UeCook/uC_Calc_CoDesign/原理图_PCB图/元器件BOM.pdf

名称 | 器件名称 | 封装参数 | 数量 | 器件供应商 | 嘉立创商城代码
51单片机 | STC89C58RD+40I-PDIP40 | DIP-40 | 1 | 宏晶科技 | C52838
LCD显示屏 | HS1602A | - | 1 | 汉昇实业 | C5329588
单刀单掷轻触开关 | TS665CJ | 6×6×5mm 直插 | 21 | 首韩 | C393938
10uF电容 | - C0805 | | 2
47pF电容 | | | 2
10KΩ电阻 | | | 2
16位排针 | 2.54-1*40P直针 | SIP16-2.54mm | 2 | 博穆精密 | C2337
8位排针 | | SIP8-2.54mm
4位排针 | | SIP4-2.54mm
无源晶振 | 12MHz ±20ppm 20pF | HC-49S | 1 | YXC扬兴晶振 | C16369
杜邦线 | - | - | 若干
晶振母座 | FH-00308 | SIP21-2.54mm | 1 | 连盛精密 | C2685110
10KΩ排阻 | A09-103JP | SIP-9-2.54mm | 2 | FH风华 | C8692
3362P 型玻璃釉预调电位器 | 3362P-1-103 | - | 1 | 成都国盛 | C118956
直插双档滑动开关 | SS-12D10L5 | - | 1 | 中国星坤 | C319012
