UeCook/uC_Calc_CoDesign/(list of files, cad)

Other CAD files:
程序代码/uC_Calc/Objects/uC_Calc.obj
程序代码/uC_Calc_mini80E开发板/Objects/uC_Calc_DBoard.obj
程序代码/uC_Calc/Objects/STARTUP.obj
程序代码/uC_Calc_mini80E开发板/Objects/STARTUP.obj
