UeCook/uC_Calc_CoDesign/原理图_PCB图/mini80E原理图.pdf

1602液晶对比度调节 | 12864液晶对比度调节

# 8位共阴数码管

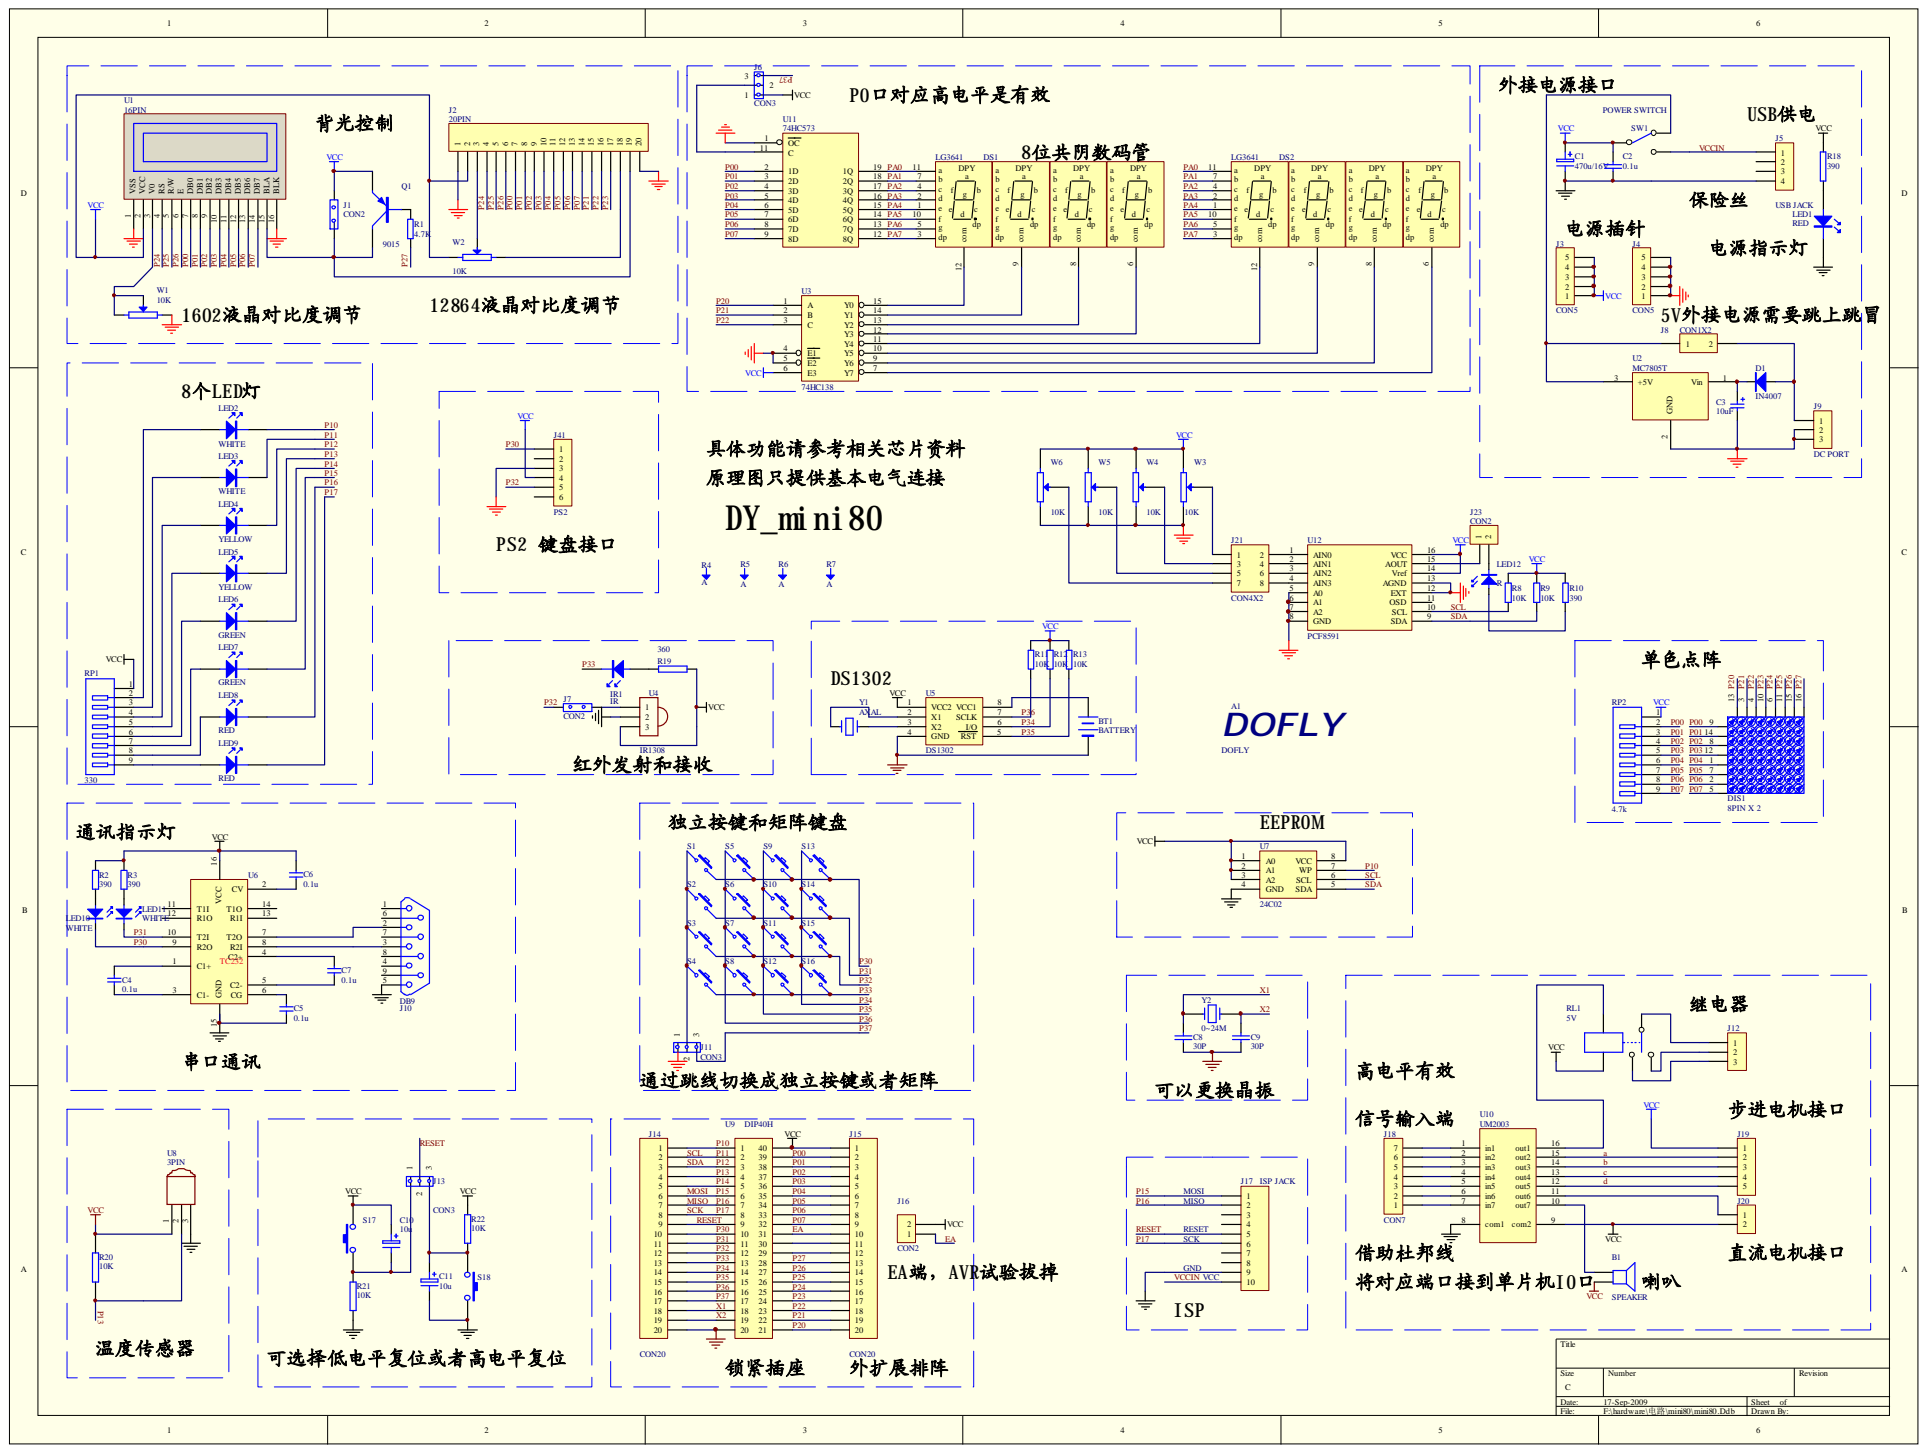
[picture p1: page 1]
