UeCook/uC_Calc_CoDesign/(list of files, drawings)

Other design files:
Proteus仿真/uC_Calc.pdsprj
原理图_PCB图/计算器原理图_带PCB（嘉立创EDA专业版）.eprj
